nledenyi/nledenyi.github.io/index.md

## Welcome to an empty site

Yeah, eventually there will be content here. Not much till that though. You can find my [linkedin page here](https://www.linkedin.com/in/norbertledenyi/) or shoot me an email at norbert dot ledenyi at gmail dot com.

## Fight COVID-19 with 3D printing

I'm printing protective face shields using Prusa's design which I remixed. More details [on this subpage](/covid19) (Hungarian).
