nledenyi/nledenyi.github.io/3d_models/RC3-mini-remix-stack6.3mf

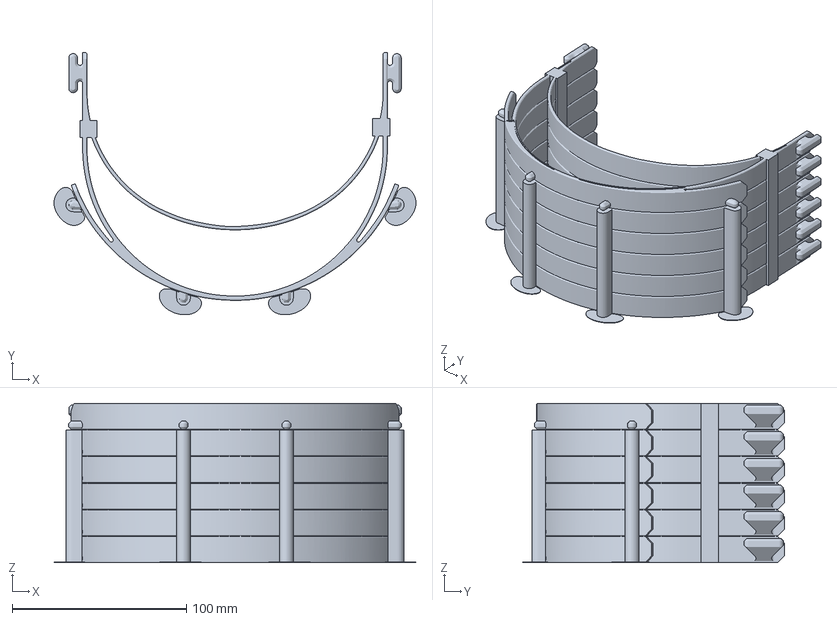
[picture p4: CAD file, 2020-04-14]
3d_models/RC3-mini-remix-stack6.3mf
207.9 x 150.7 x 91.5 mm
