nledenyi/nledenyi.github.io/3d_models/RC3-mini-remix.3mf

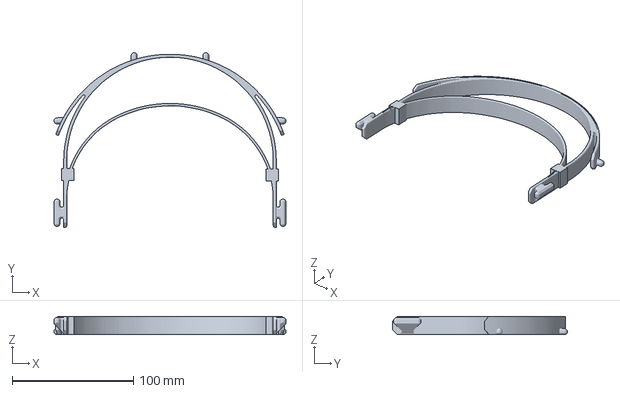
[picture p5: CAD file, 2020-04-08]
3d_models/RC3-mini-remix.3mf
191.0 x 143.8 x 15.0 mm
