nledenyi/nledenyi.github.io/3d_models/RC3-mini-remix-stack4.3mf

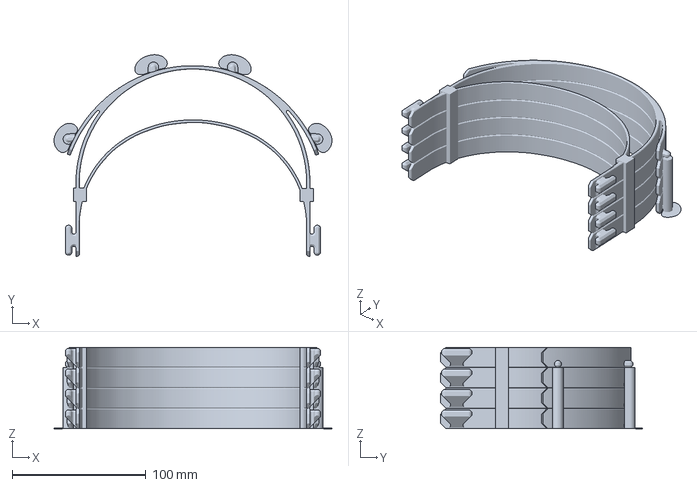
[picture p6: CAD file, 2020-04-08]
3d_models/RC3-mini-remix-stack4.3mf
207.9 x 150.7 x 60.9 mm
