nledenyi/nledenyi.github.io/3d_models/RC3-mini-remix-stack2.3mf

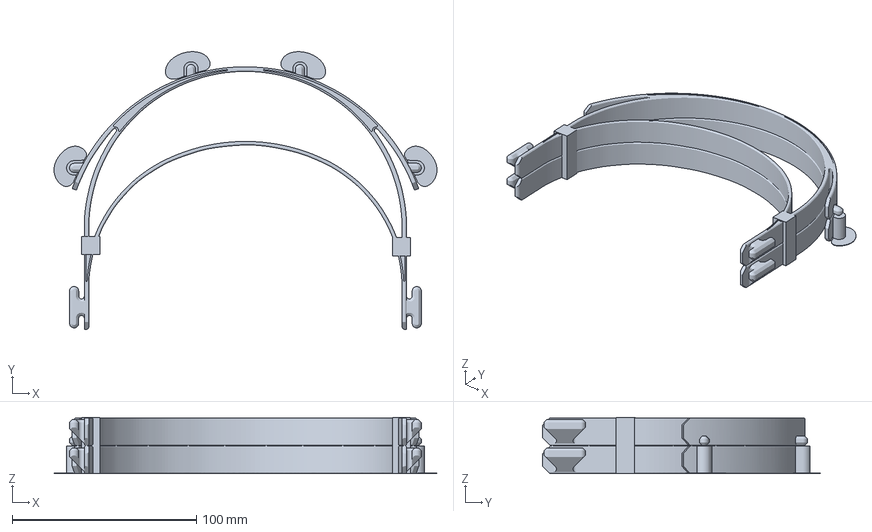
[picture p7: CAD file, 2020-04-08]
3d_models/RC3-mini-remix-stack2.3mf
207.9 x 150.7 x 30.5 mm
