nledenyi/nledenyi.github.io/(list of files, cad)

Other CAD files:
3d_models/RC3-mini-remix-stack2.stl
3d_models/RC3-mini-remix.stl
