nledenyi/nledenyi.github.io/(commit log)

2020-04-08 upload models
    [RC3-mini-remix-stack2.stl, RC3-mini-remix.stl]
2020-04-13 updated stack of 6
    [RC3-mini-remix-stack6.3mf]
2020-04-14 stack6 update
    [RC3-mini-remix-stack6.3mf]
